MikeFentonNZ/Casio-calculator-picaxe-esp-datalogger-upgrade/photos_video/casio-picaxe-temperature-calibration.png

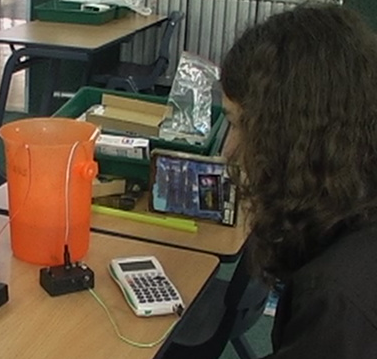
photos_video/casio-picaxe-temperature-calibration.png
