MikeFentonNZ/Casio-calculator-picaxe-esp-datalogger-upgrade/photos_video/Casio-Arduino.jpg

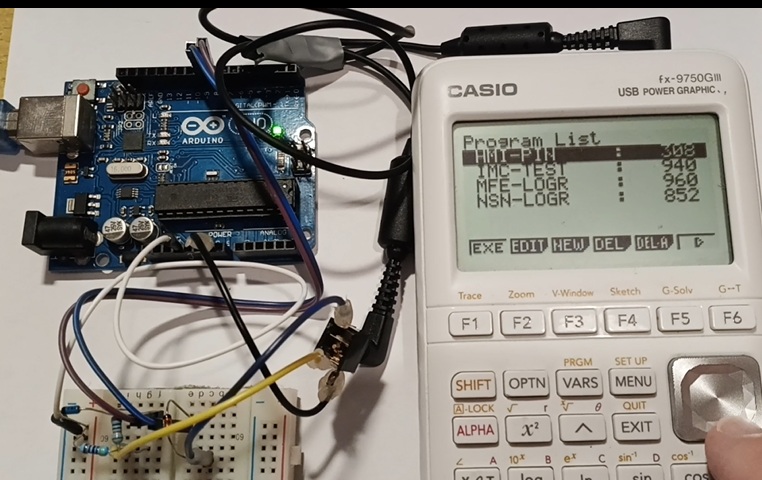
photos_video/Casio-Arduino.jpg
