MikeFentonNZ/Casio-calculator-picaxe-esp-datalogger-upgrade/photos_video/Youtube video links.txt

https://www.youtube.com/@nznrg

The robot B9 from the TV show “Lost in Space” (4 versions for different school age groups)
https://youtu.be/Dm2rruRP2XI  - Roll with me B9    (the nature of science and seeing first-hand)
https://youtu.be/yCJ5pwdDt6A
https://youtu.be/0Cg1Fd_HSMU

Coding and AI as a partner – soundtracks to make learning feel good!
https://youtu.be/UJegjTEAs5A   - Apple II Transylvania remake for modern web browsers

Props and models – perspective and engineering in science fiction – music track for “Land of the Giants” TV
https://youtu.be/s1xazris0Pk  - Ballad of the Spindrift

Casio calculator demonstration videos 
https://youtu.be/GLPgoy_6pYA  - 2025 demonstration video
https://www.youtube.com/j07YRWUmnFo - ESP32
https://www.youtube.com/1iDPcnTAIhg - Arduino Uno R3
https://www.youtube.com/ulXrOckG5Lw - BBC Microbit V1 & V2
https://www.youtube.com/khCzVW4PZOY - Picaxe 08M2 & 14M2
