MikeFentonNZ/Casio-calculator-picaxe-esp-datalogger-upgrade/photos_video/Casio-ESP3-webserver.png

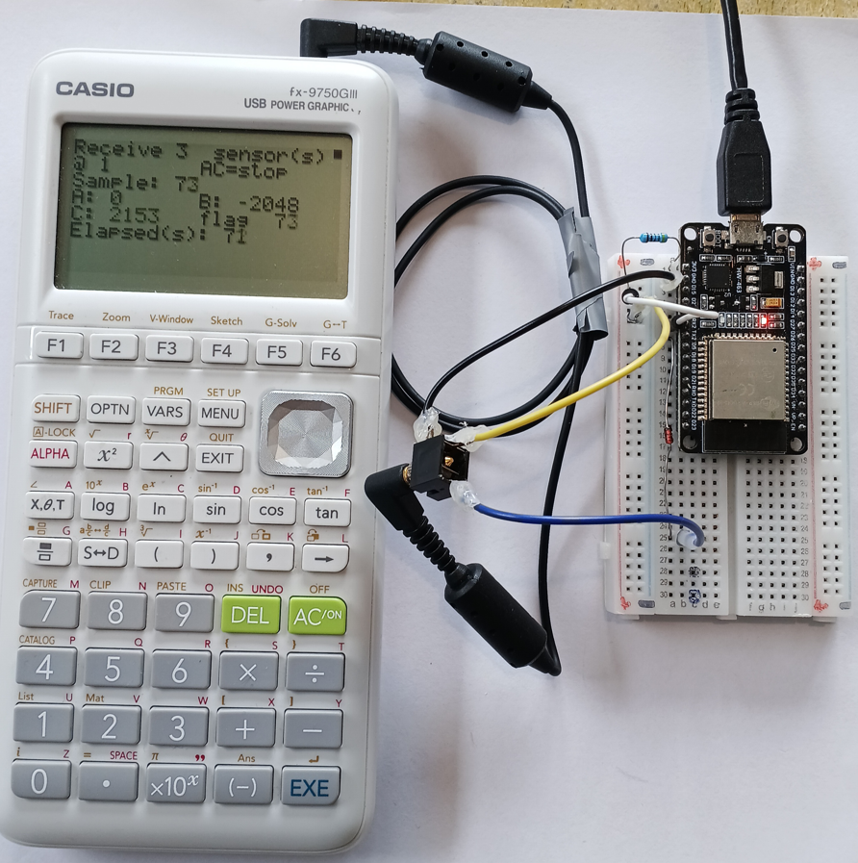
photos_video/Casio-ESP3-webserver.png
