MikeFentonNZ/Casio-calculator-picaxe-esp-datalogger-upgrade/photos_video/Casio-Microbit.png

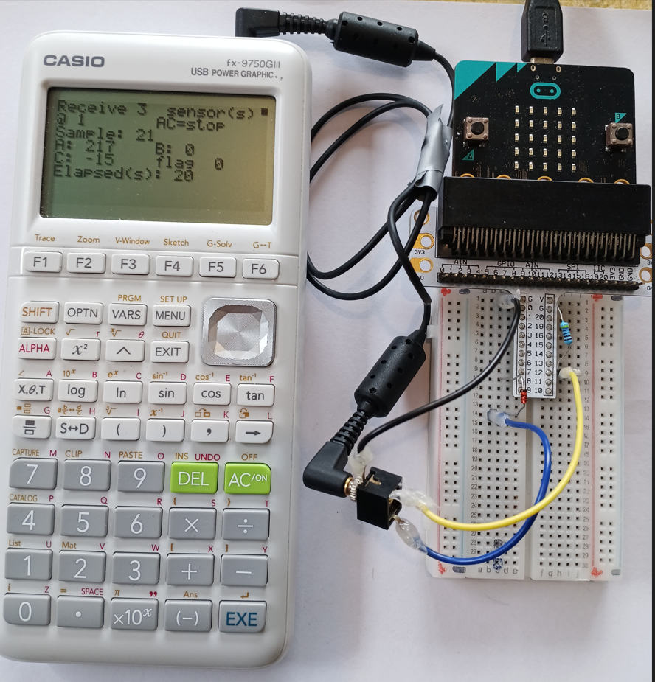
photos_video/Casio-Microbit.png
