MikeFentonNZ/Casio-calculator-picaxe-esp-datalogger-upgrade/photos_video/casio-picaxe-list-data.jpg

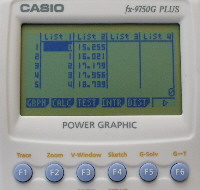
photos_video/casio-picaxe-list-data.jpg
