MikeFentonNZ/Casio-calculator-picaxe-esp-datalogger-upgrade/photos_video/casio-picaxe-mission-to-mars.jpg

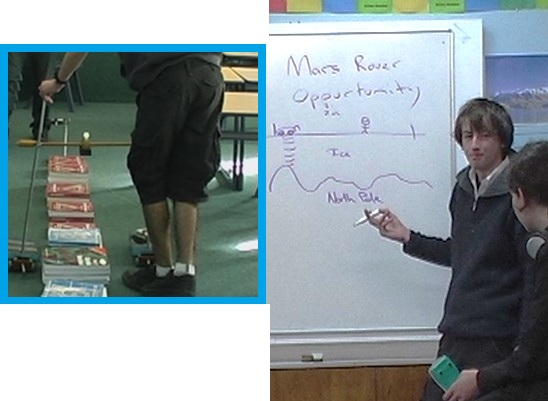
photos_video/casio-picaxe-mission-to-mars.jpg
