MikeFentonNZ/Casio-calculator-picaxe-esp-datalogger-upgrade/photos_video/Casio-range-finder-terrain-mapping.JPG

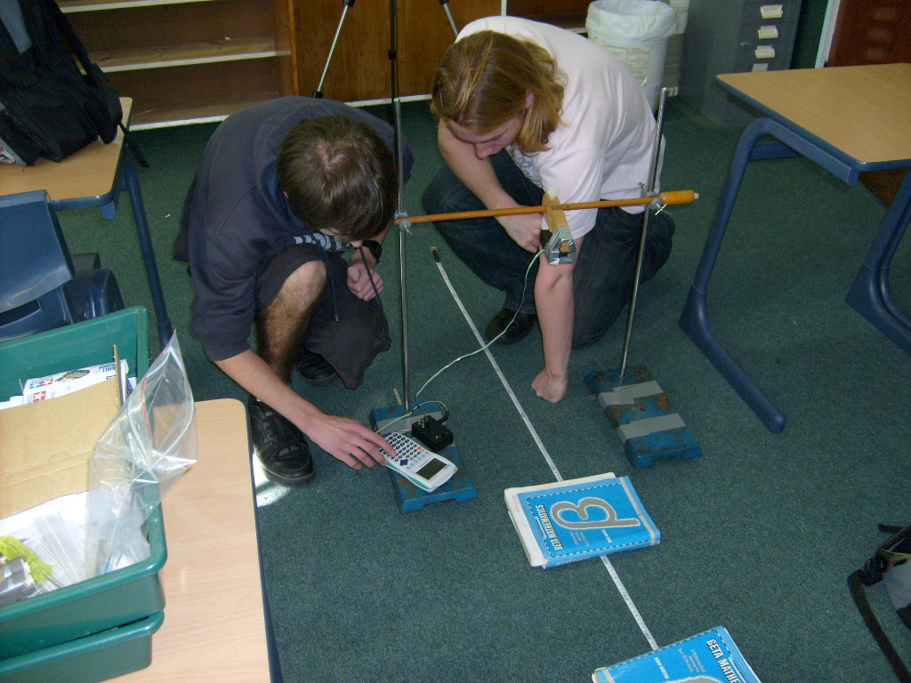
photos_video/Casio-range-finder-terrain-mapping.JPG
