MikeFentonNZ/Casio-calculator-picaxe-esp-datalogger-upgrade/photos_video/Casio-sensor-packs.JPG

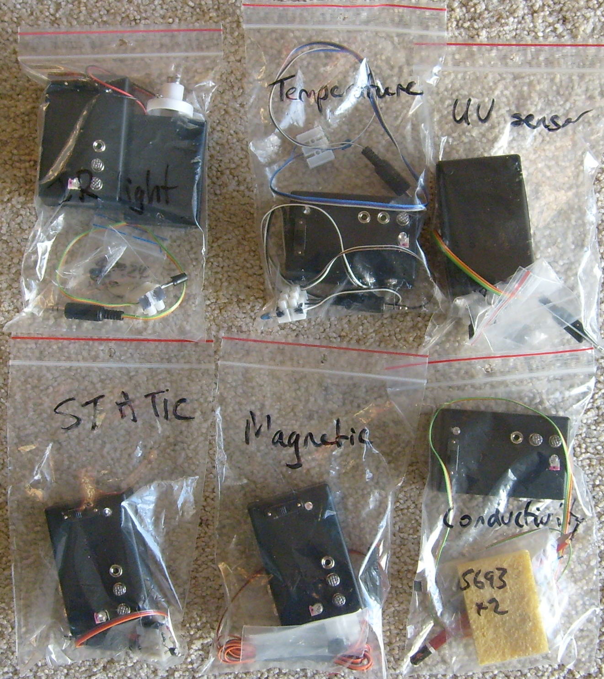
photos_video/Casio-sensor-packs.JPG
