MikeFentonNZ/Casio-calculator-picaxe-esp-datalogger-upgrade/photos_video/Casio-Wemos-ESP8266-webserver.png

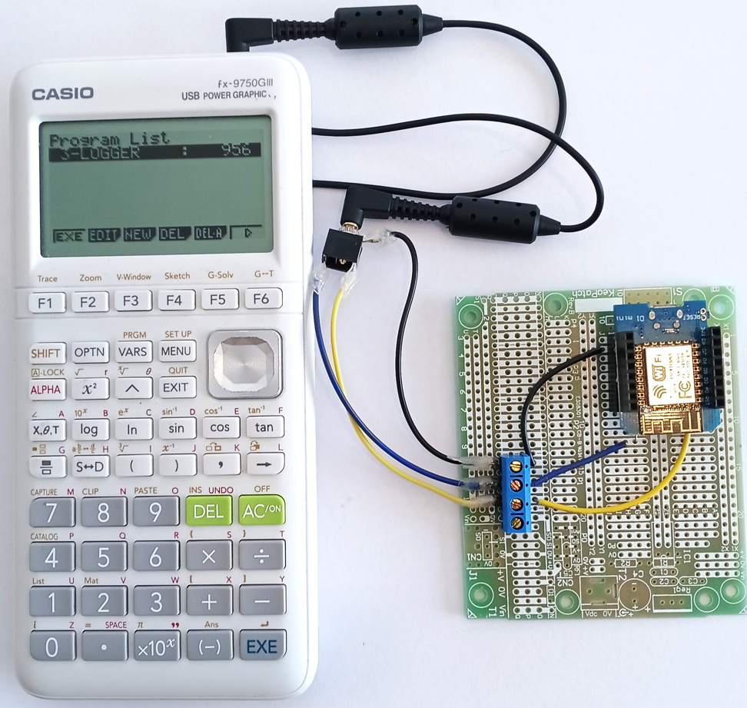
photos_video/Casio-Wemos-ESP8266-webserver.png
