MikeFentonNZ/Casio-calculator-picaxe-esp-datalogger-upgrade/photos_video/figure-2-host-wait-windows.png

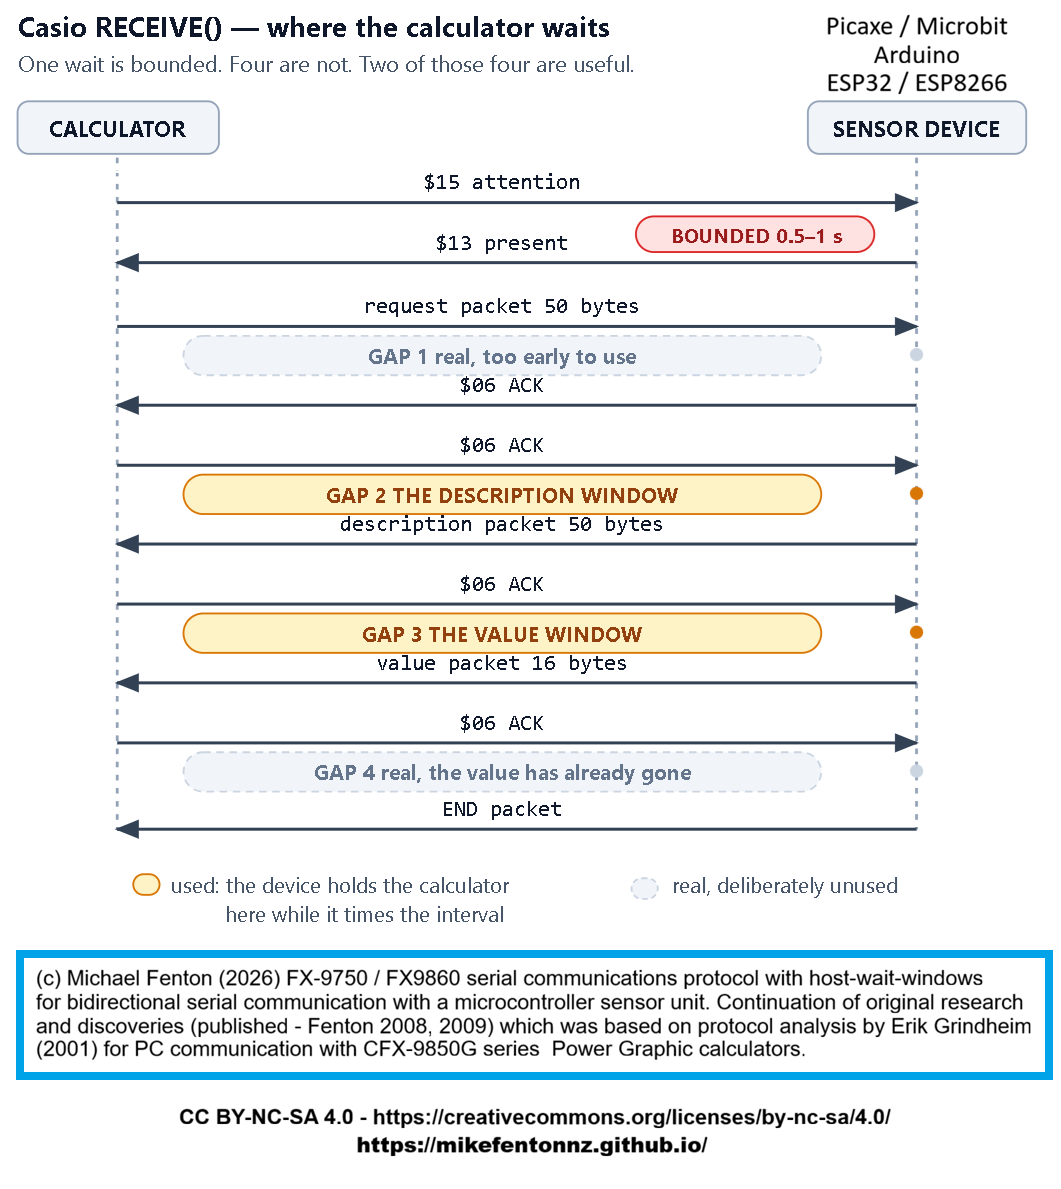
photos_video/figure-2-host-wait-windows.png
