MikeFentonNZ/Casio-calculator-picaxe-esp-datalogger-upgrade/photos_video/MArs-Rover-planning.GIF

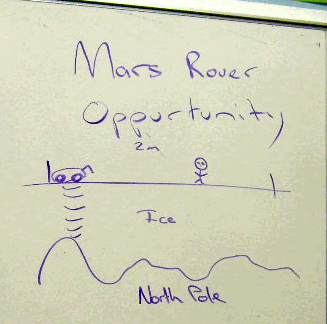
photos_video/MArs-Rover-planning.GIF
