MikeFentonNZ/Casio-calculator-picaxe-esp-datalogger-upgrade/photos_video/michael-fenton-casio-all-platforms.png

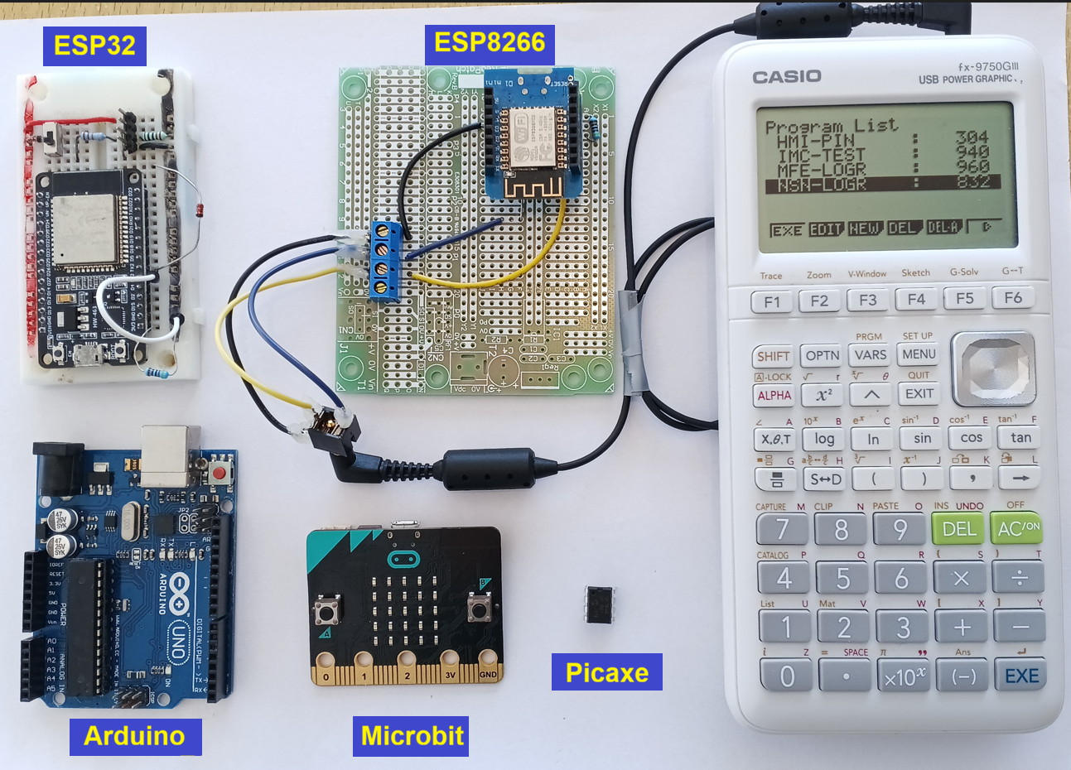
photos_video/michael-fenton-casio-all-platforms.png
