MikeFentonNZ/Casio-calculator-picaxe-esp-datalogger-upgrade/photos_video/michael-fenton-casio-FX9750GIII-ESP8266.jpg

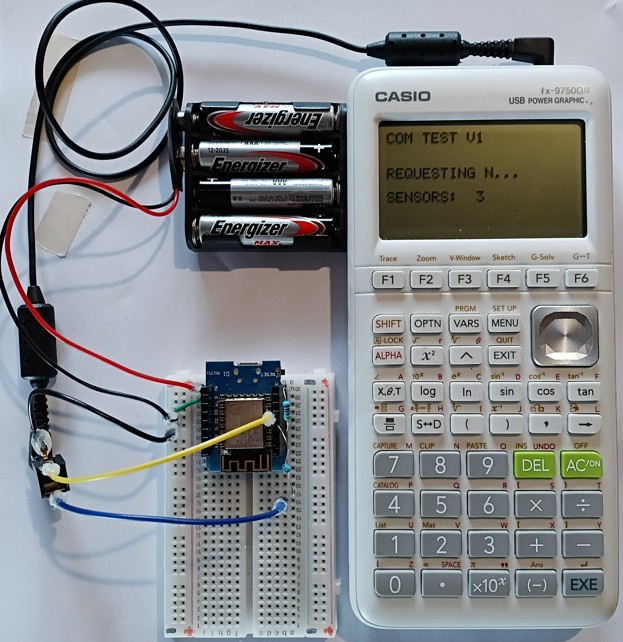
photos_video/michael-fenton-casio-FX9750GIII-ESP8266.jpg
