MikeFentonNZ/Casio-calculator-picaxe-esp-datalogger-upgrade/photos_video/michael-fenton-picaxe-casio.jpg

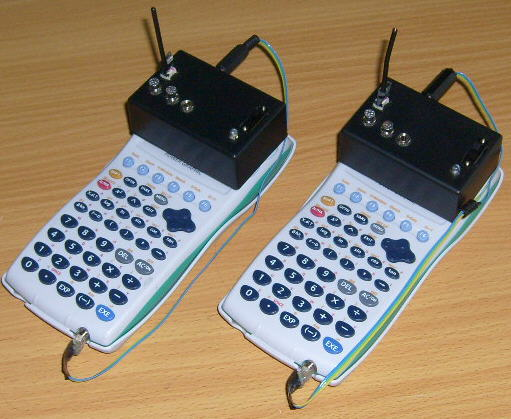
photos_video/michael-fenton-picaxe-casio.jpg
