MikeFentonNZ/Casio-calculator-picaxe-esp-datalogger-upgrade/photos_video/motion_sensor.JPG

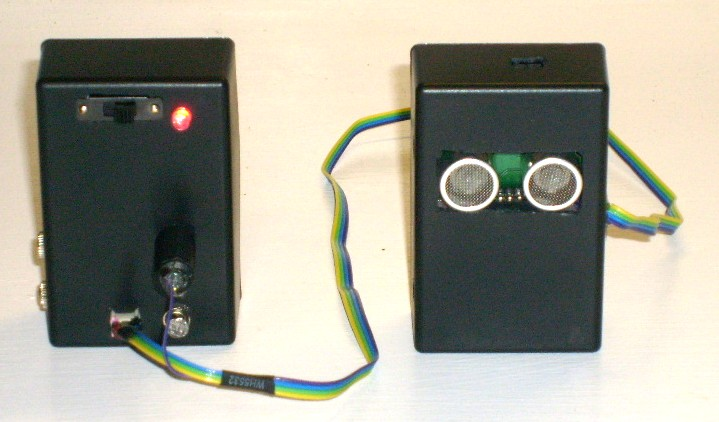
photos_video/motion_sensor.JPG
