MikeFentonNZ/Casio-calculator-picaxe-esp-datalogger-upgrade/photos_video/Sensor-unit-with-radio.JPG

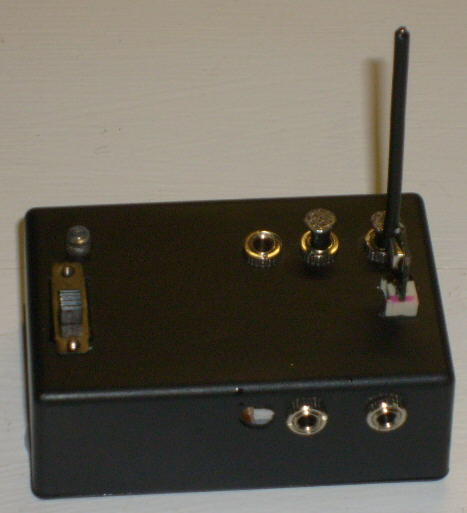
photos_video/Sensor-unit-with-radio.JPG
