MikeFentonNZ/Casio-calculator-picaxe-esp-datalogger-upgrade/photos_video/figure-1-sb62-wiring.png

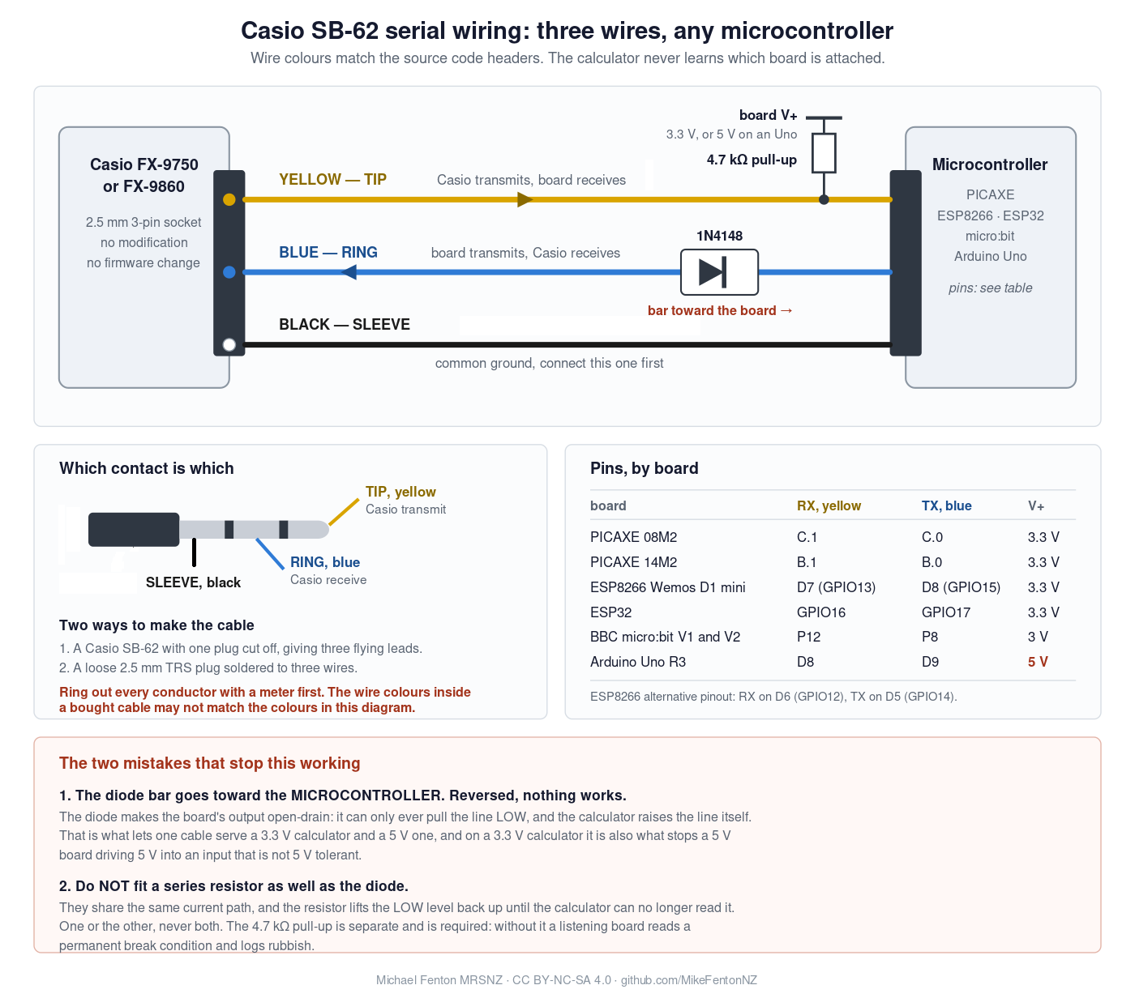
photos_video/figure-1-sb62-wiring.png
