MikeFentonNZ/Casio-calculator-picaxe-esp-datalogger-upgrade/photos_video/michael-fenton-casio-serial-protocol-manual.png

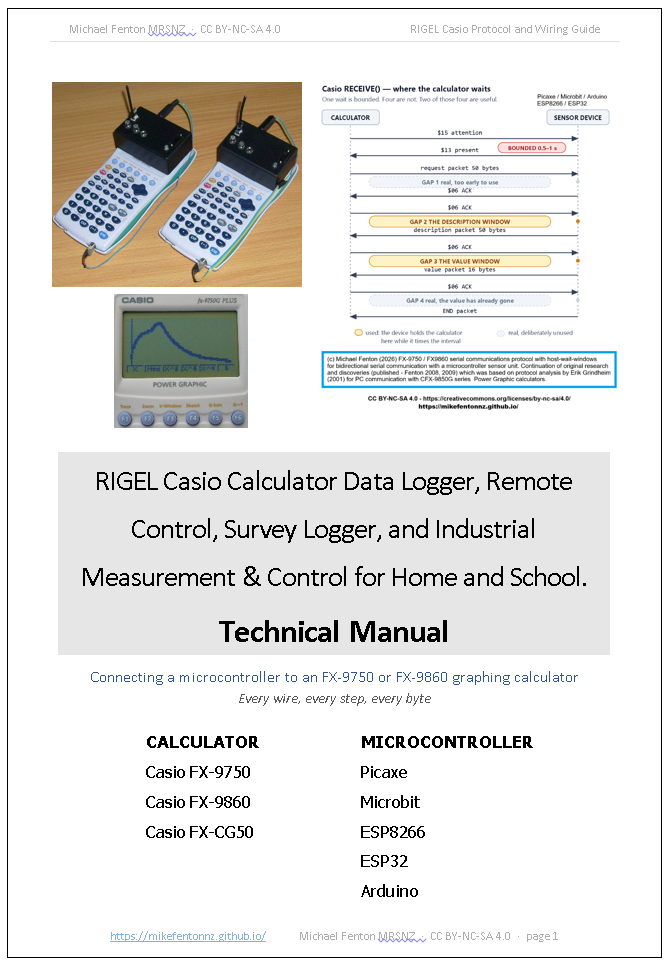
photos_video/michael-fenton-casio-serial-protocol-manual.png
