MikeFentonNZ/Casio-calculator-picaxe-esp-datalogger-upgrade/serial_protocol_technical-manual/casio-calculator-send.png

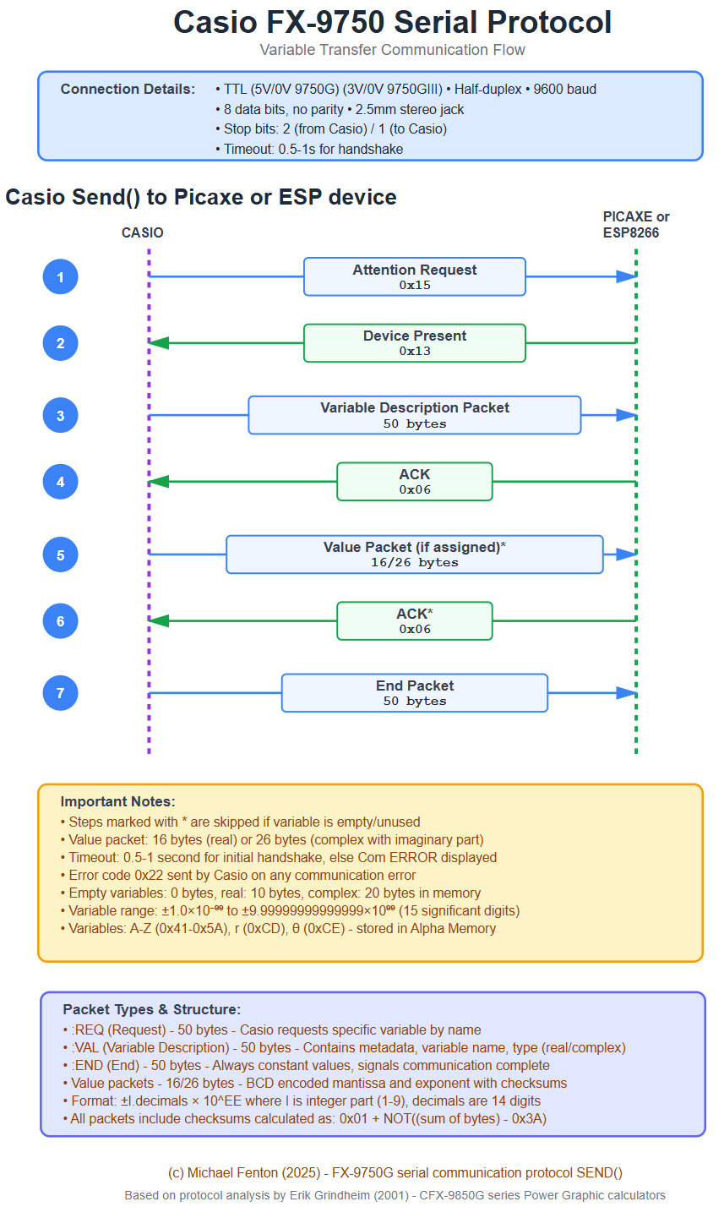
serial_protocol_technical-manual/casio-calculator-send.png
