MikeFentonNZ/Casio-calculator-picaxe-esp-datalogger-upgrade/serial_protocol_technical-manual/casio-universal-interface.png

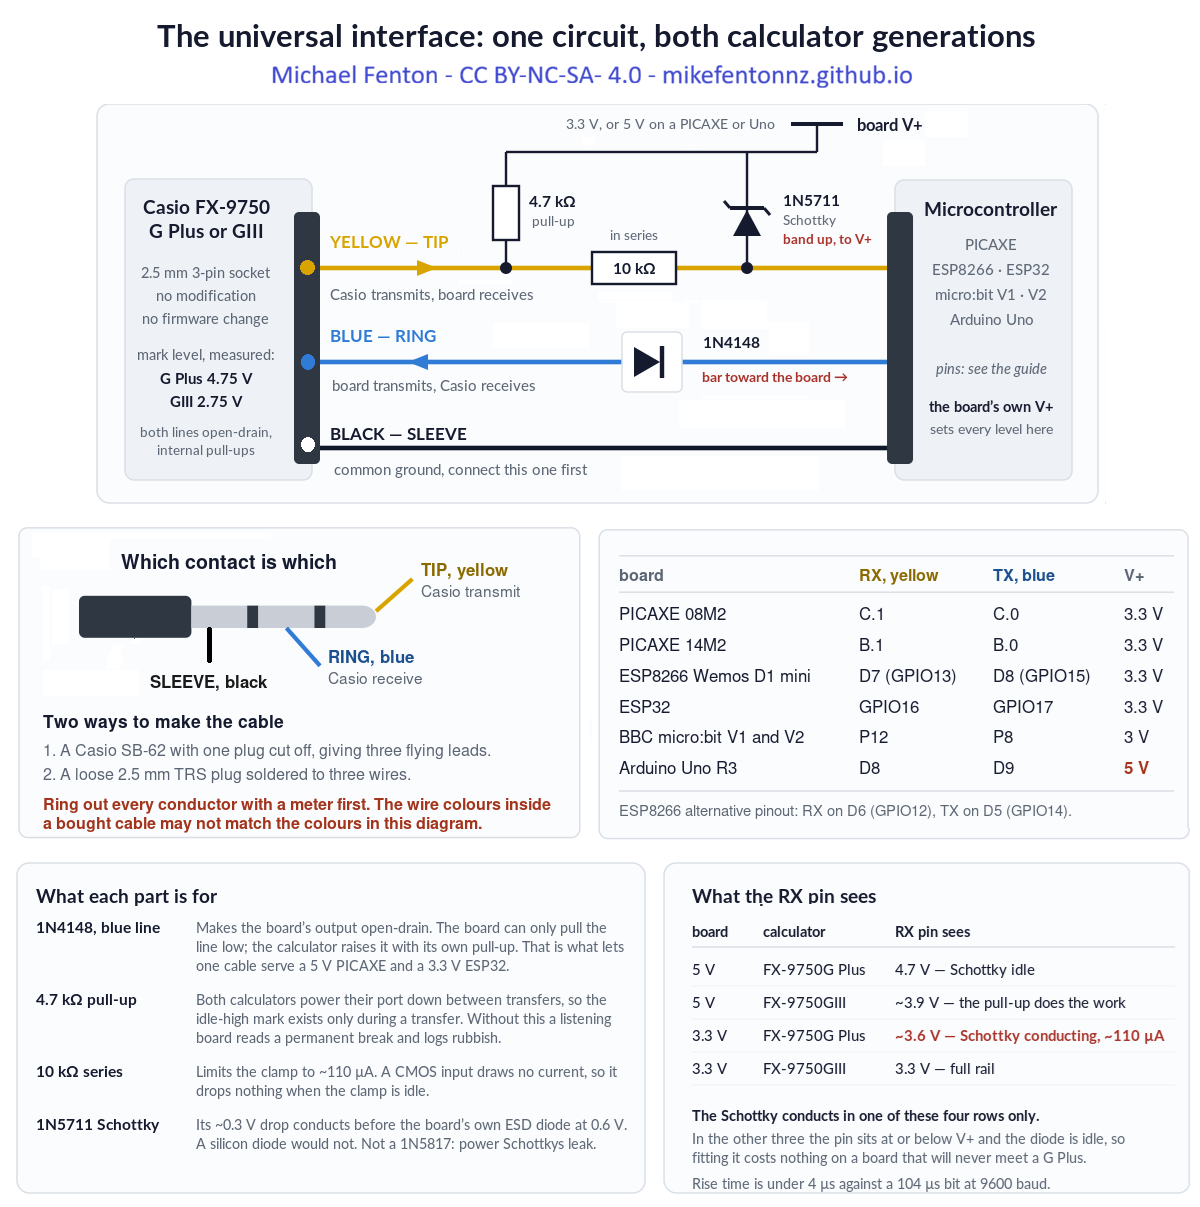
serial_protocol_technical-manual/casio-universal-interface.png
